rustyJ4ck/EeePC701/bios/DEV/readme.md

#### DEV BIOS EEEPC 701/900 (Celeron M)

This firmware version is designed for TESTING purposes only. There are no guarantees whatsoever; use it at your own risk.

> [!CAUTION]
> I Don't recommend using this BIOS for now! It's here for testing.
> Some fuctions does not work correctly when BCLK133 mode selected.
> Required CMOS reset to boot after power off. SATA drives stop working correctly due to pcie overclock.

Currently testing proper BCLK 133 MHz overclocking (via bootblock) before MRC code trains the MCH/DRAM and system acknowledge 133 MHz bus. 

Some features may be broken (like sleep mode)

BIOS options:  

**DRAM Frequency** = 533 -> Enable BCLK 133 MOD

**Configure DRAM Timing by SPD**
= DISABLED -> will choose tightest possible timings to improve latency

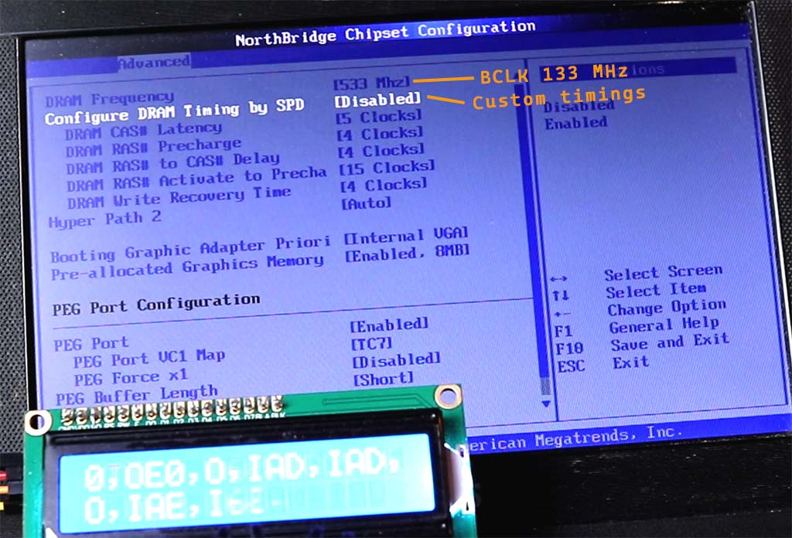
[picture p4: docs/images/bios_bclk.jpg]
133 BIOS Setup


To run 133 BCLK with CL3 DRAM, CPU Vcore need to be adjusted to 0.94v [CPU Voltmod](https://github.com/rustyJ4ck/EeePC701/tree/main/docs/voltmod_cpu)* 

##### EEEPC-900
The BIOS defaults to using the 701 screen profile. To enable a 900 resolution, you need to manually choose this option in the BIOS setup: 
Advanced -> NB -> Video -> LFP Panel type:

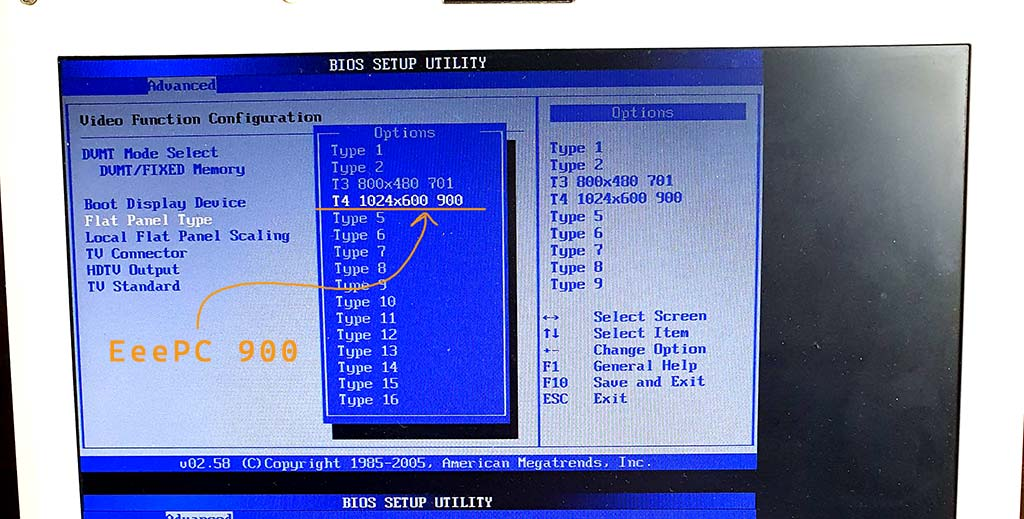
[picture p5: docs/images/900_lfp.jpg]


Aida memory benchmark (BCLK 133 MHz CPU ~1200 MHz)

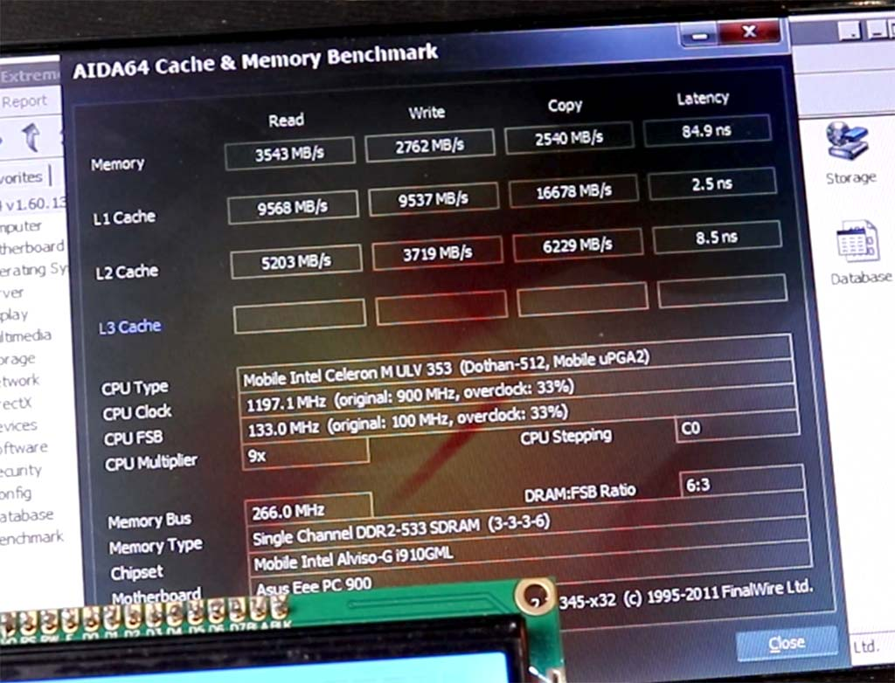
[picture p6: docs/images/cachemem_133.jpg]
133 MHz aida benchmark
