rustyJ4ck/EeePC701/docs/esp_ec_log/readme.txt

Reading EC KB 3310 debug output via serial connection to D1 Mini (esp 8266)

esp_ec_kb3310/esp_ec_kb3310.ino
--
Simple serial EC -> Arduino log reader

esp_ec_lcd/esp_ec_lcd.ino
--
ESP8266 sketch to display CPU Temp & FAN RPM monitor EC reading to 2x16 LCD display

ec_monitor/ec_monitor.py
--
Serial EC pol parseer / CPU Temp & FAN RPM monitor
