rustyJ4ck/EeePC701/docs/ahci/bios_ahci_opts.jpg

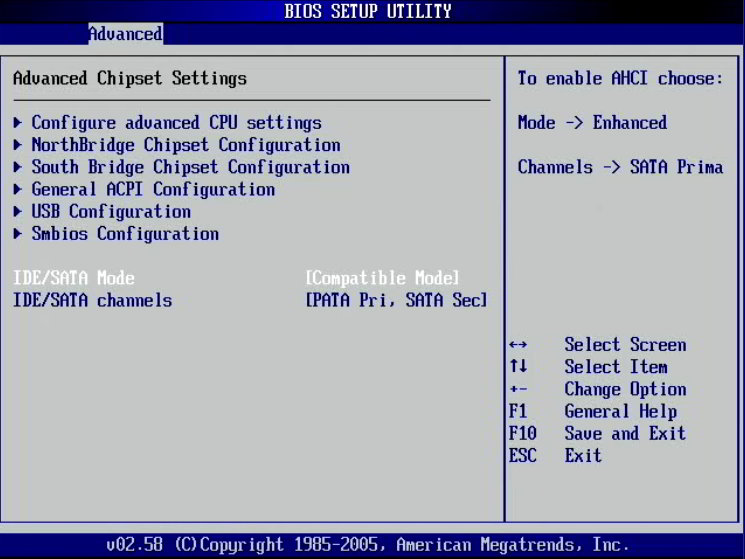
docs/ahci/bios_ahci_opts.jpg
