rustyJ4ck/EeePC701/docs/ahci/bios_ideconf_asm.png

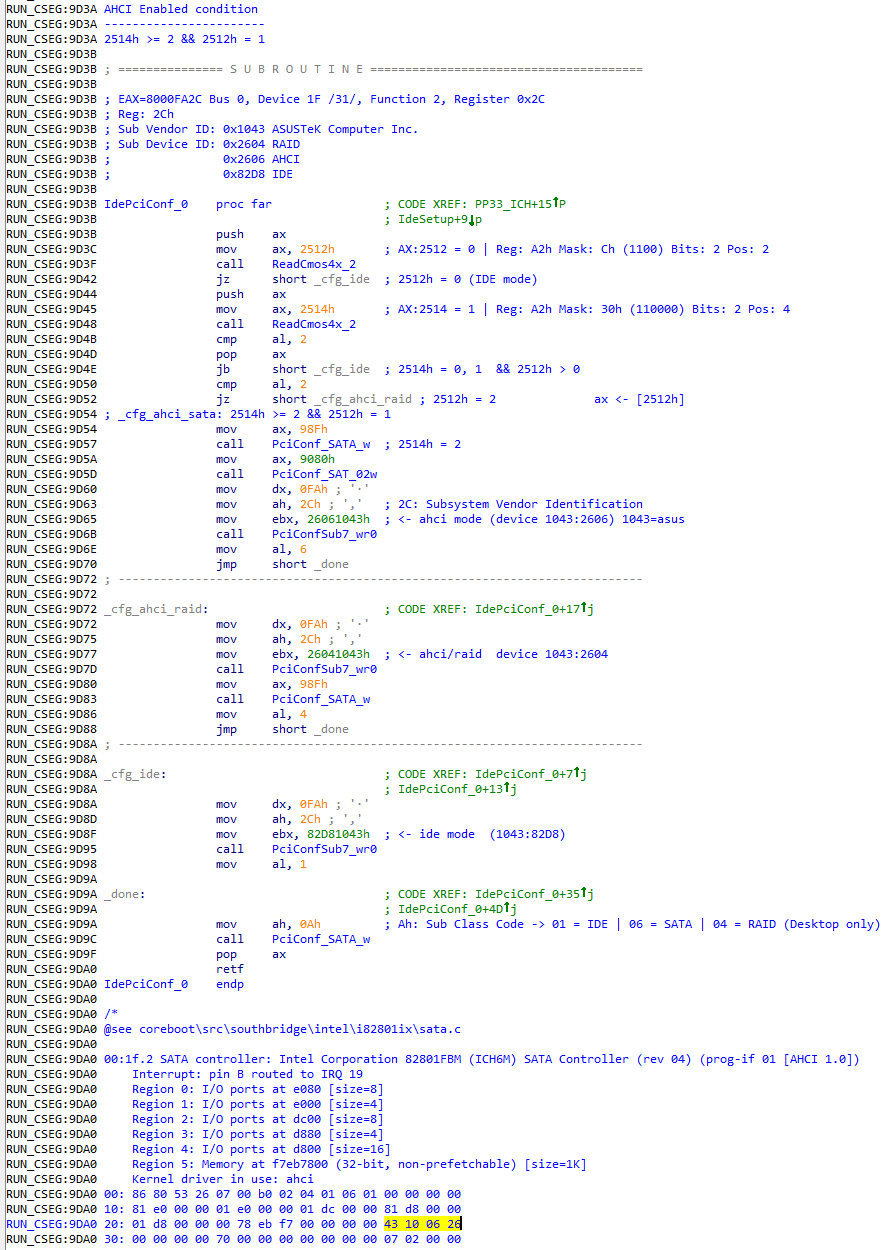
docs/ahci/bios_ideconf_asm.png
