rustyJ4ck/EeePC701/docs/ahci/devmgr_xp.png

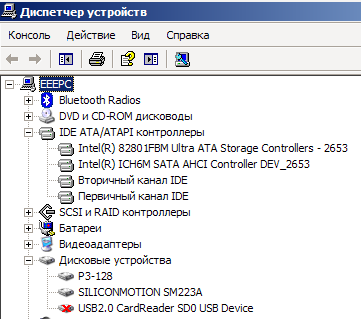
docs/ahci/devmgr_xp.png
