rustyJ4ck/EeePC701/docs/ahci/diskmark.png

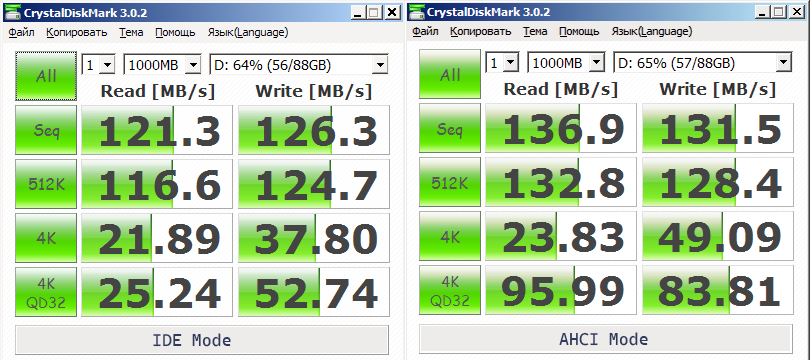
docs/ahci/diskmark.png
