rustyJ4ck/EeePC701/docs/dram_timings/bootblock-force-cl3.png

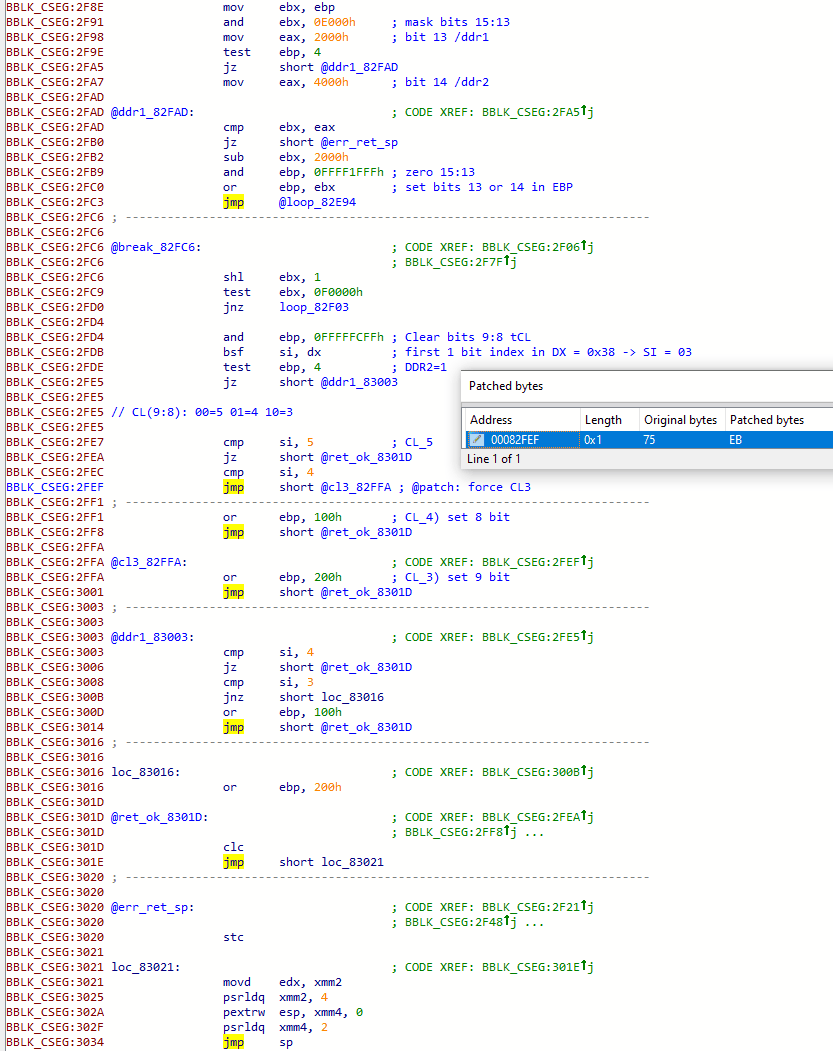
docs/dram_timings/bootblock-force-cl3.png
