rustyJ4ck/EeePC701/docs/esp_ec_log/ec_lcd.jpg

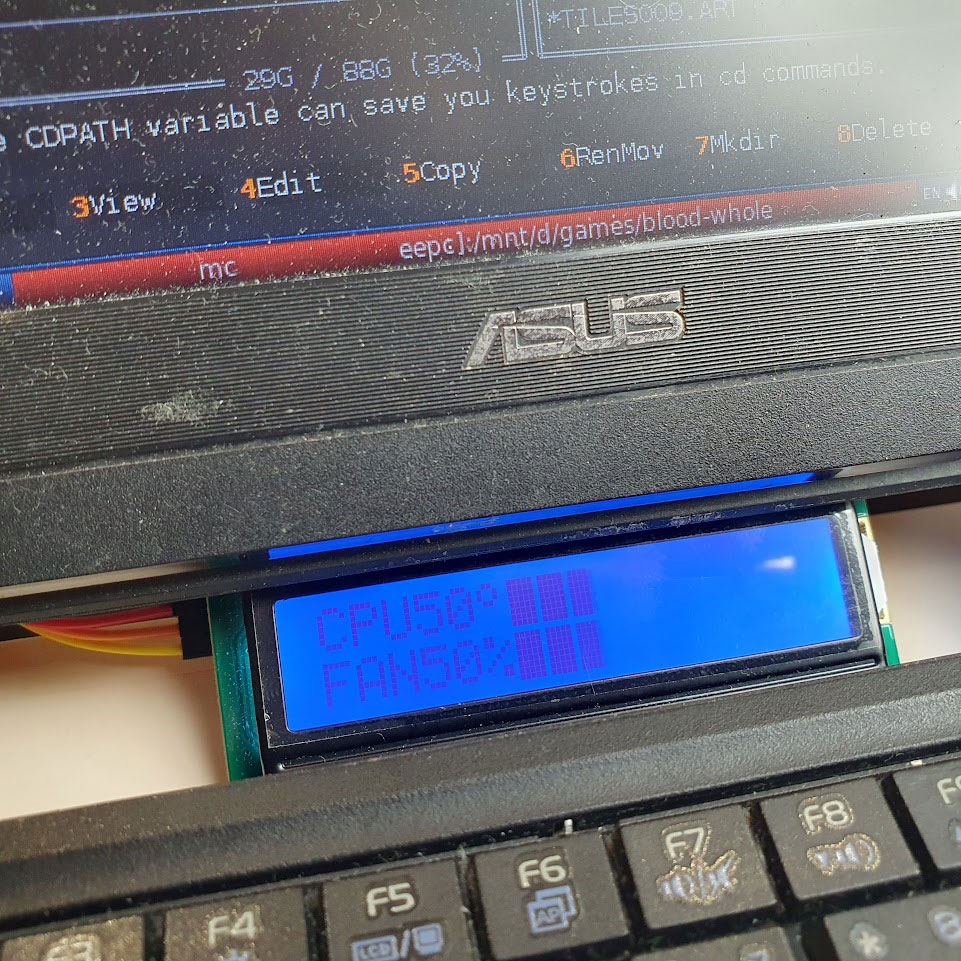
docs/esp_ec_log/ec_lcd.jpg
