rustyJ4ck/EeePC701/docs/esp_ec_log/esp_ec_kb3310/esp_ec_kb3310.jpg

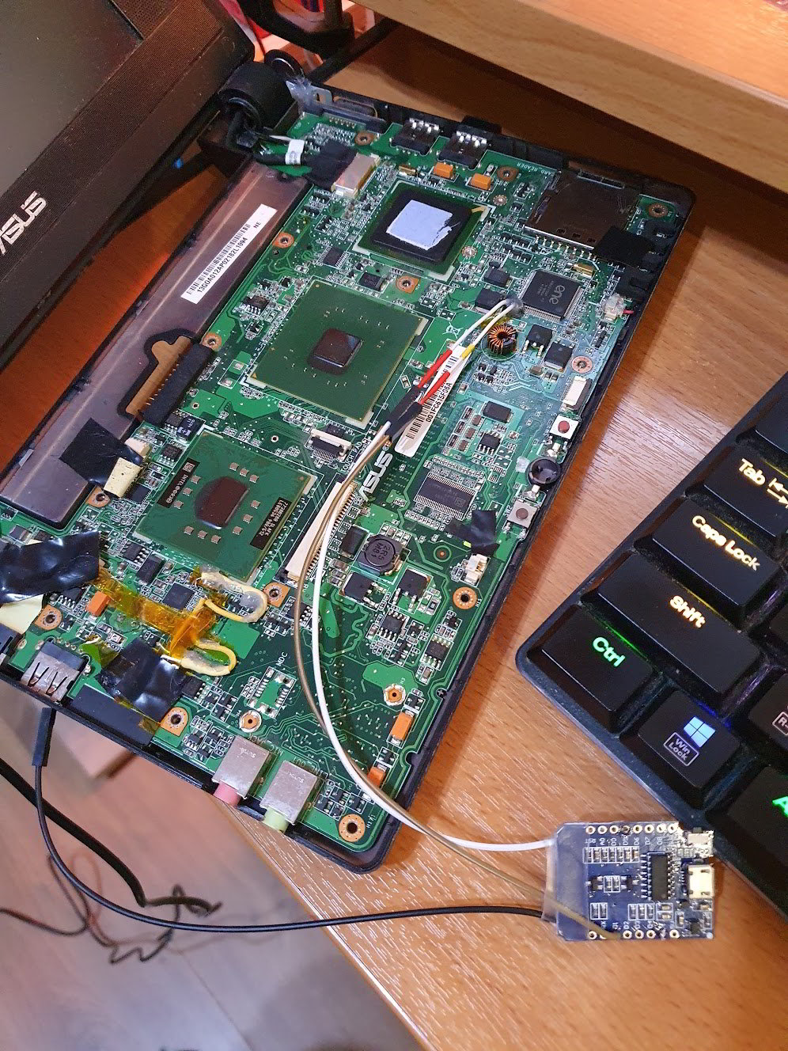
docs/esp_ec_log/esp_ec_kb3310/esp_ec_kb3310.jpg
