rustyJ4ck/EeePC701/docs/esp_ec_log/esp_ec_kb3310/kb3310_uart_pins.jpg

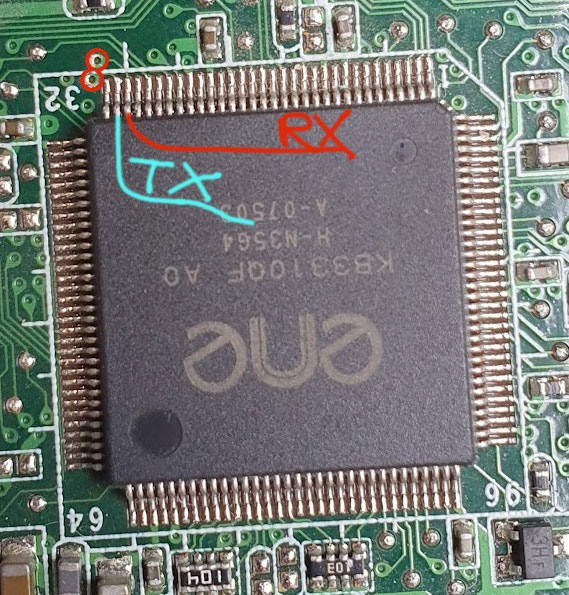
docs/esp_ec_log/esp_ec_kb3310/kb3310_uart_pins.jpg
