rustyJ4ck/EeePC701/docs/fsb_overclock/1125mhz-fsb-125-pcie-117.jpg

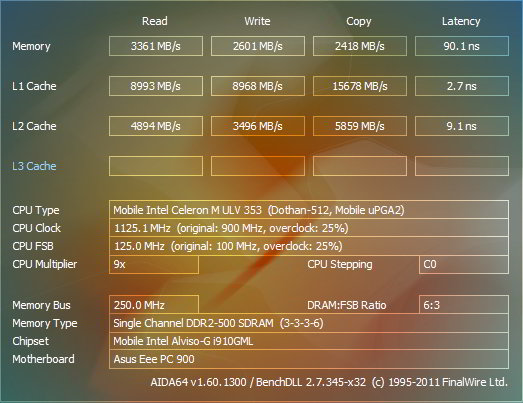
docs/fsb_overclock/1125mhz-fsb-125-pcie-117.jpg
