rustyJ4ck/EeePC701/docs/ssd_2.5/20241107_175440.jpg

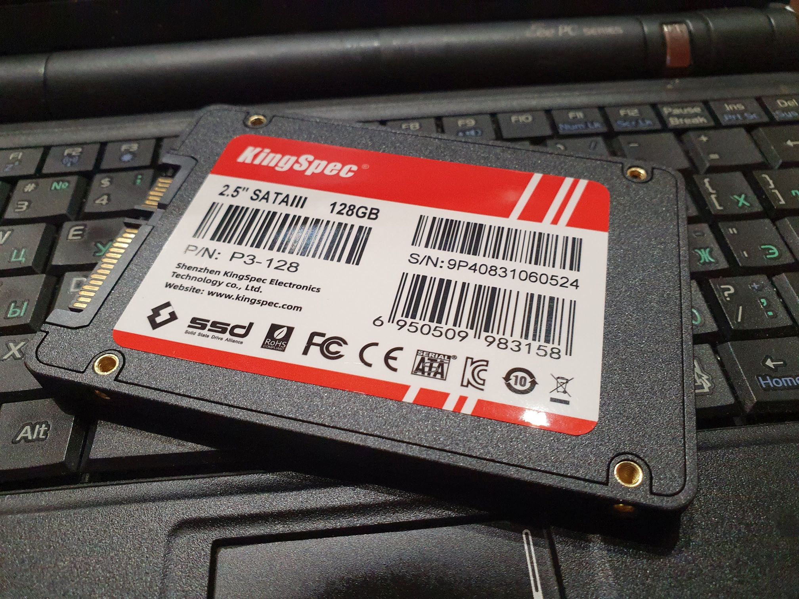
docs/ssd_2.5/20241107_175440.jpg
