rustyJ4ck/EeePC701/docs/ssd_2.5/20241107_180939.jpg

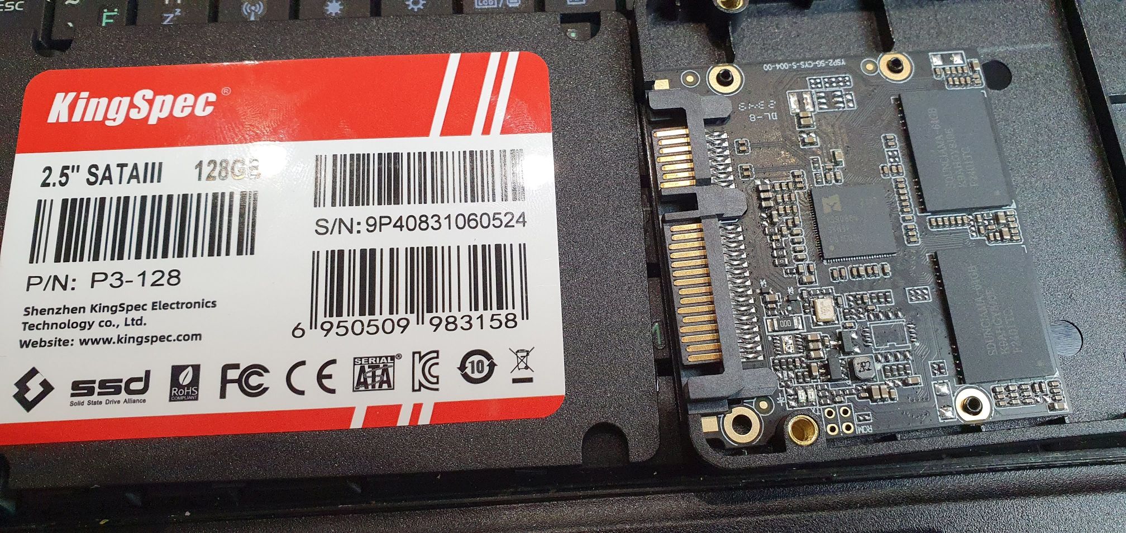
docs/ssd_2.5/20241107_180939.jpg
