rustyJ4ck/EeePC701/docs/ssd_2.5/20241108_200246.jpg

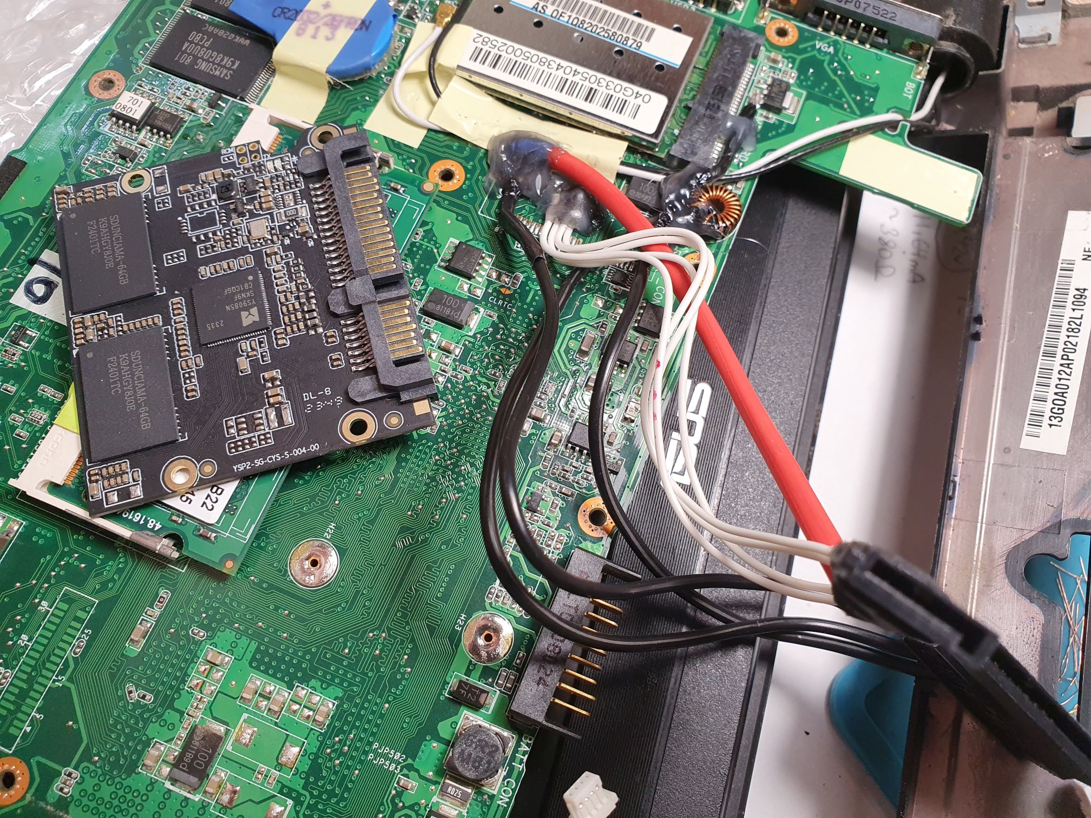
docs/ssd_2.5/20241108_200246.jpg
