rustyJ4ck/EeePC701/docs/ssd_2.5/20241110_185753.jpg

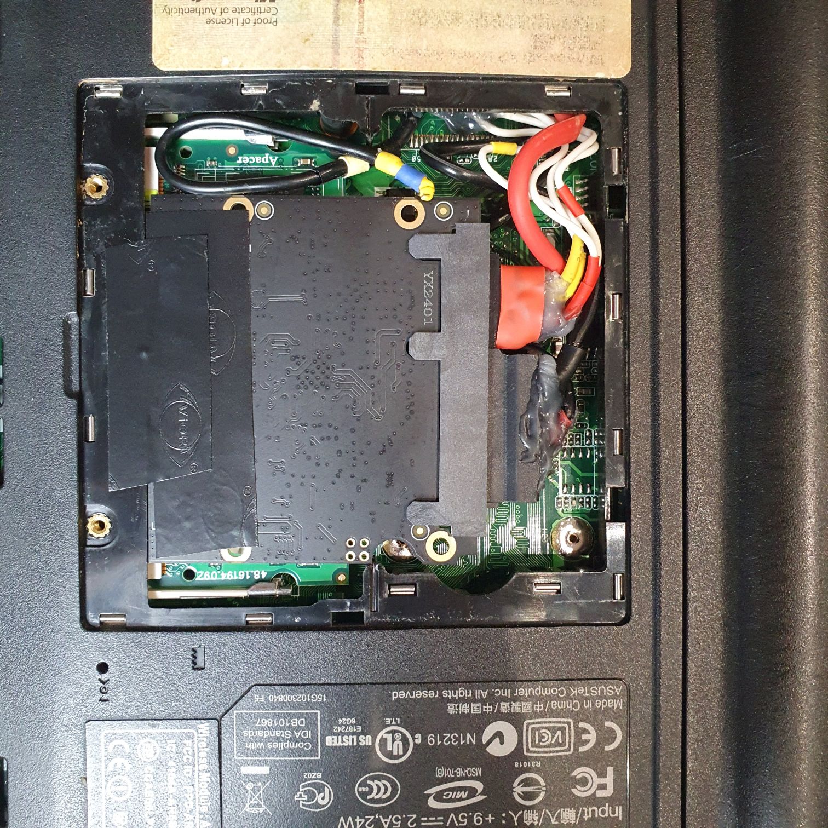
docs/ssd_2.5/20241110_185753.jpg
