rustyJ4ck/EeePC701/docs/ssd_2.5/20241110_190017.jpg

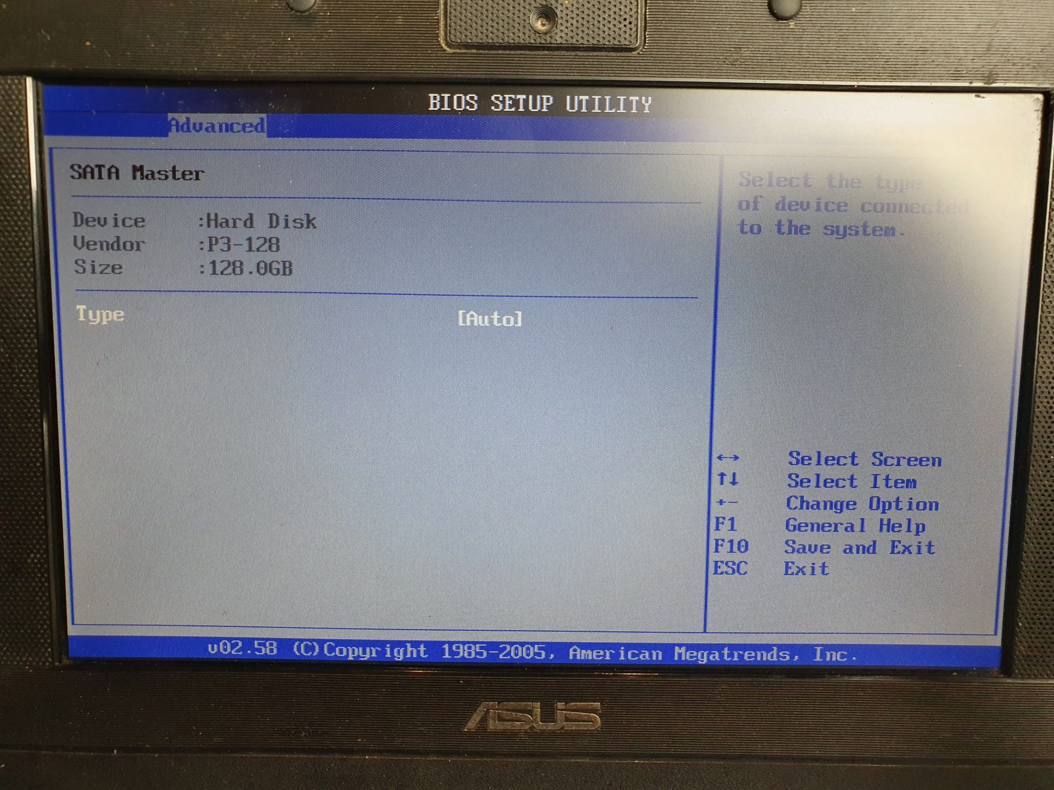
docs/ssd_2.5/20241110_190017.jpg
