rustyJ4ck/EeePC701/docs/ssd_2.5/sata_connector.jpg

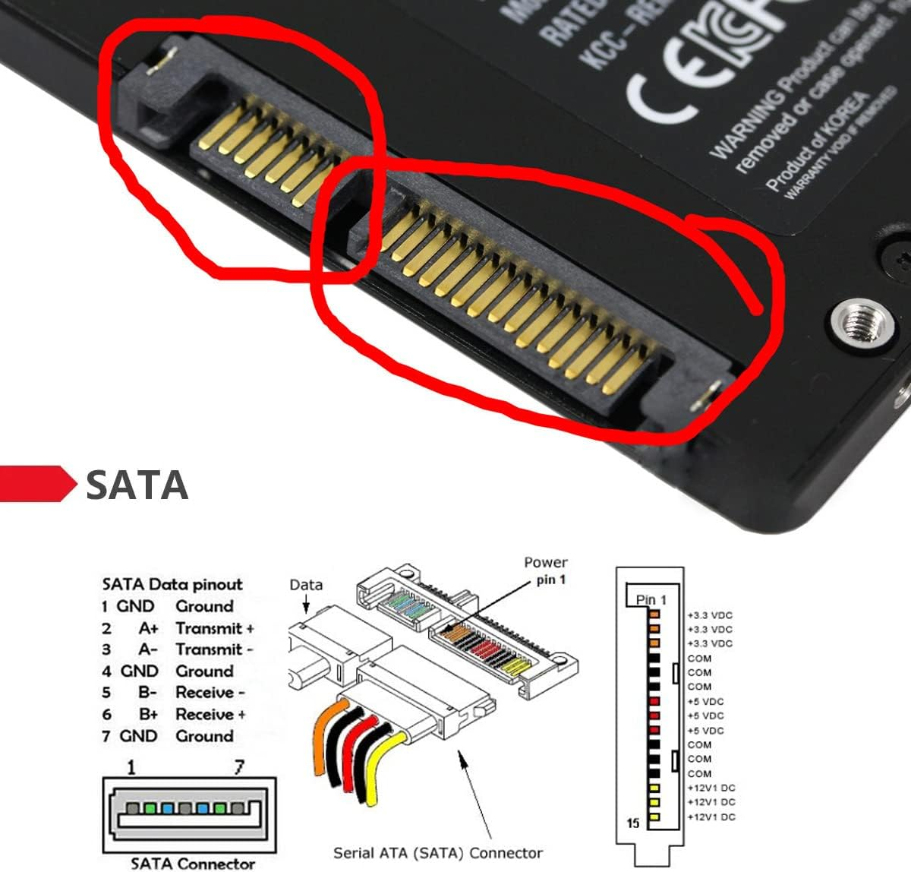
docs/ssd_2.5/sata_connector.jpg
