rustyJ4ck/EeePC701/docs/ssd_2.5/sata_pinout.jpg

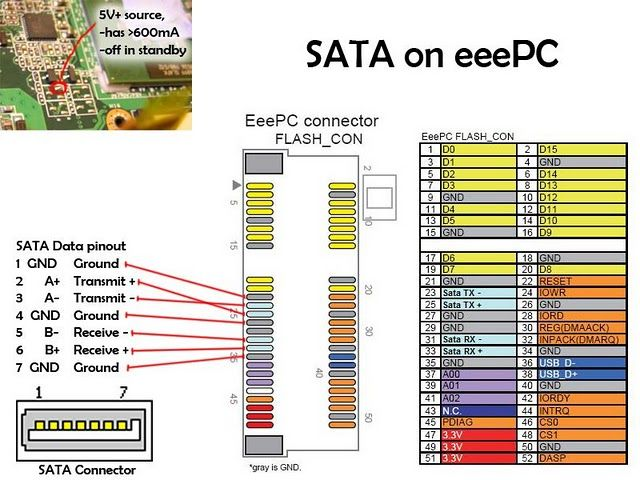
docs/ssd_2.5/sata_pinout.jpg
