rustyJ4ck/EeePC701/docs/uprgade/2gb_ddr2.jpg

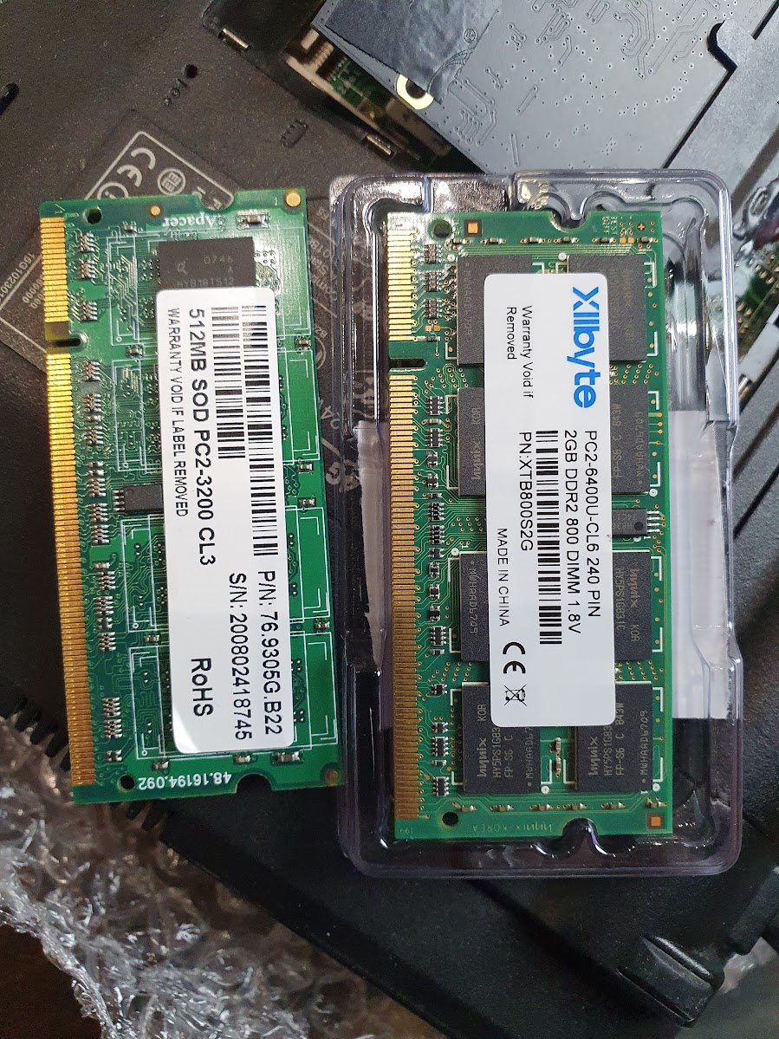
docs/uprgade/2gb_ddr2.jpg
