rustyJ4ck/EeePC701/docs/uprgade/ath_wb222_wifi_bt_5g.jpg

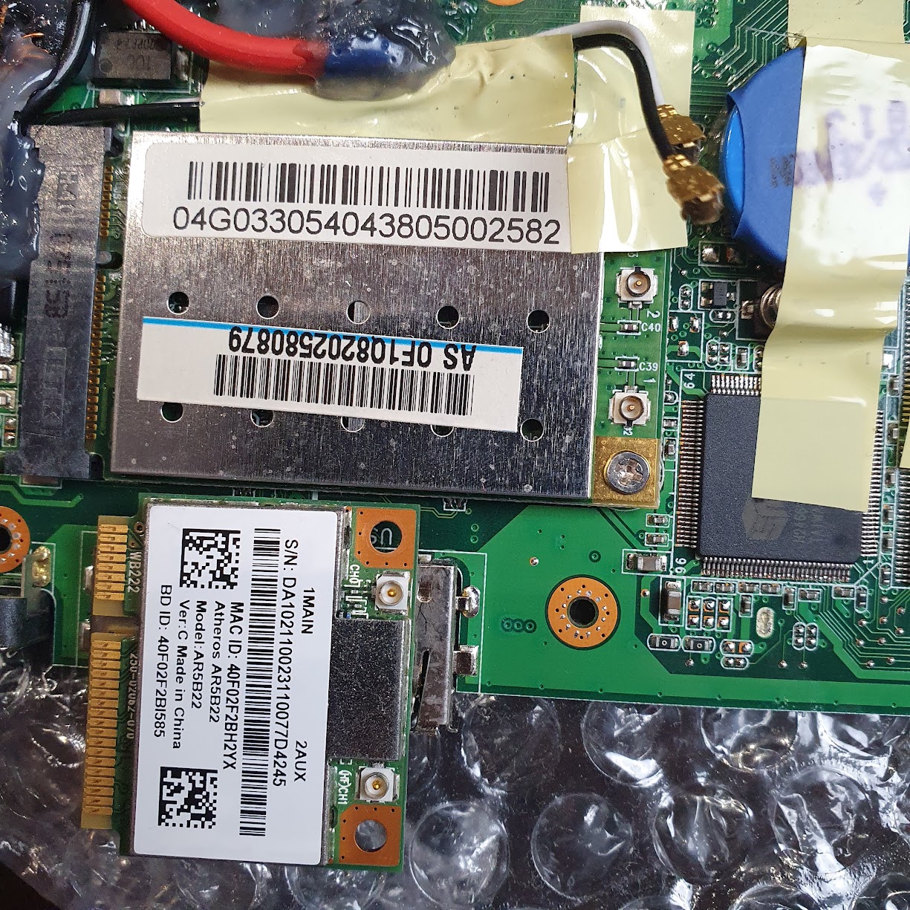
docs/uprgade/ath_wb222_wifi_bt_5g.jpg
