rustyJ4ck/EeePC701/docs/voltmod_cpu/701_vrm_voltmod.jpg

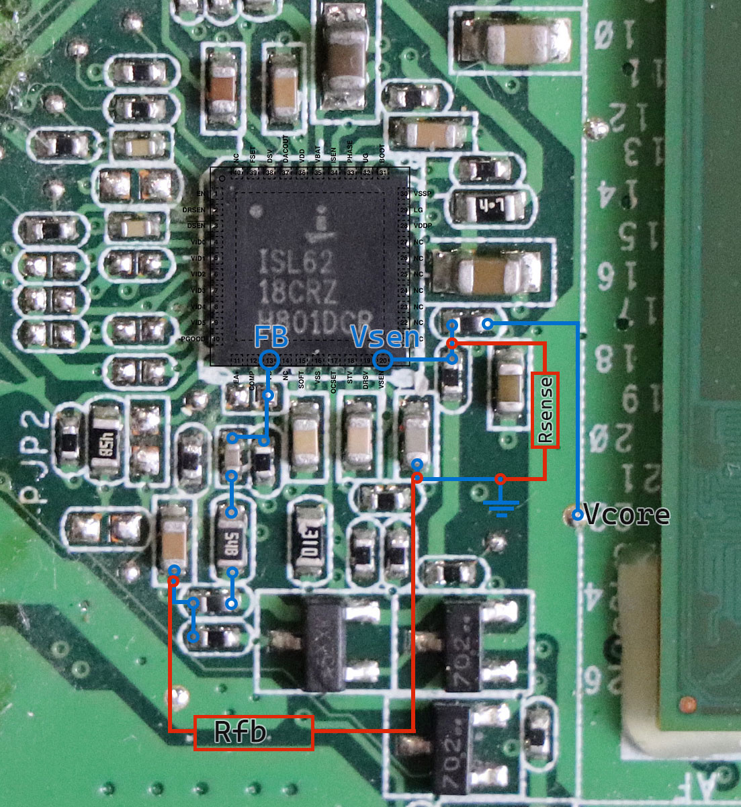
docs/voltmod_cpu/701_vrm_voltmod.jpg
